Hello-FPGA/BISS-C/doc/BISS_EB-SCH.pdf

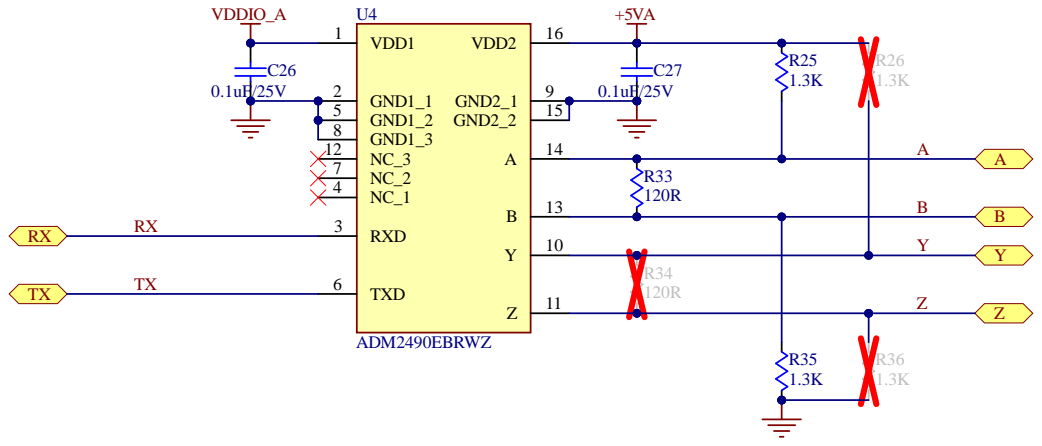
[picture p5: page 1]

R evisio n | Modified desc riptions / ECN List | Date | | roduct Num: Title: P roduct Title : | ' ' * | Che cked By: | X X X

Schematic Revision History | | | BISS_EB | Designed By: | X X X | Cannot open fi le \ Chenhy\pcb设计相关资 料 \Proj e c t模板 \ Logo2020.png. Fi le does not exi s t .

P | ' | Approve By: | X

evision | | She et: | / * | Siz e | A | R ele ase Date | :

Schematic Revision History | | | Title: | BISS_EB | Designed By: | XXX | Cannot open file \Chenhy\pcb设计相关资料\Project模板\Logo2020.png. File does not exist.

Revision | Modified descriptions / ECN List | Date | | | Product Title: | ''* | Checked By: | XXX

Product Num: | '' | Approve By: | XXX

Revision: | V01 | Sheet: | * * | Size: | A3 | Release Date: | 2021/11/23

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

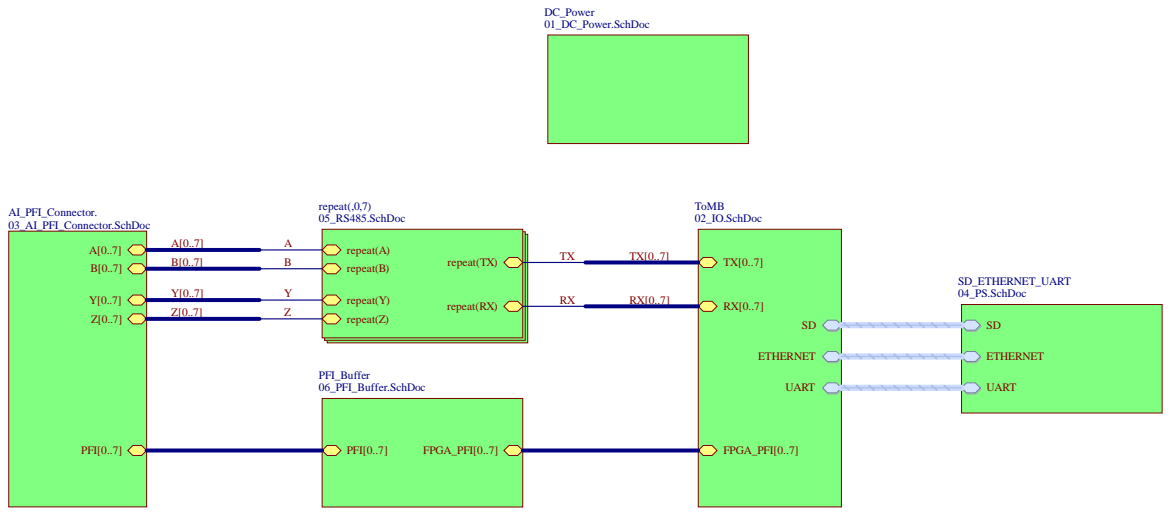
[picture p6: page 9]
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

Revision | Modified descriptions / ECN List | Date | | | Product Title: | ''* | Checked By: | XXX

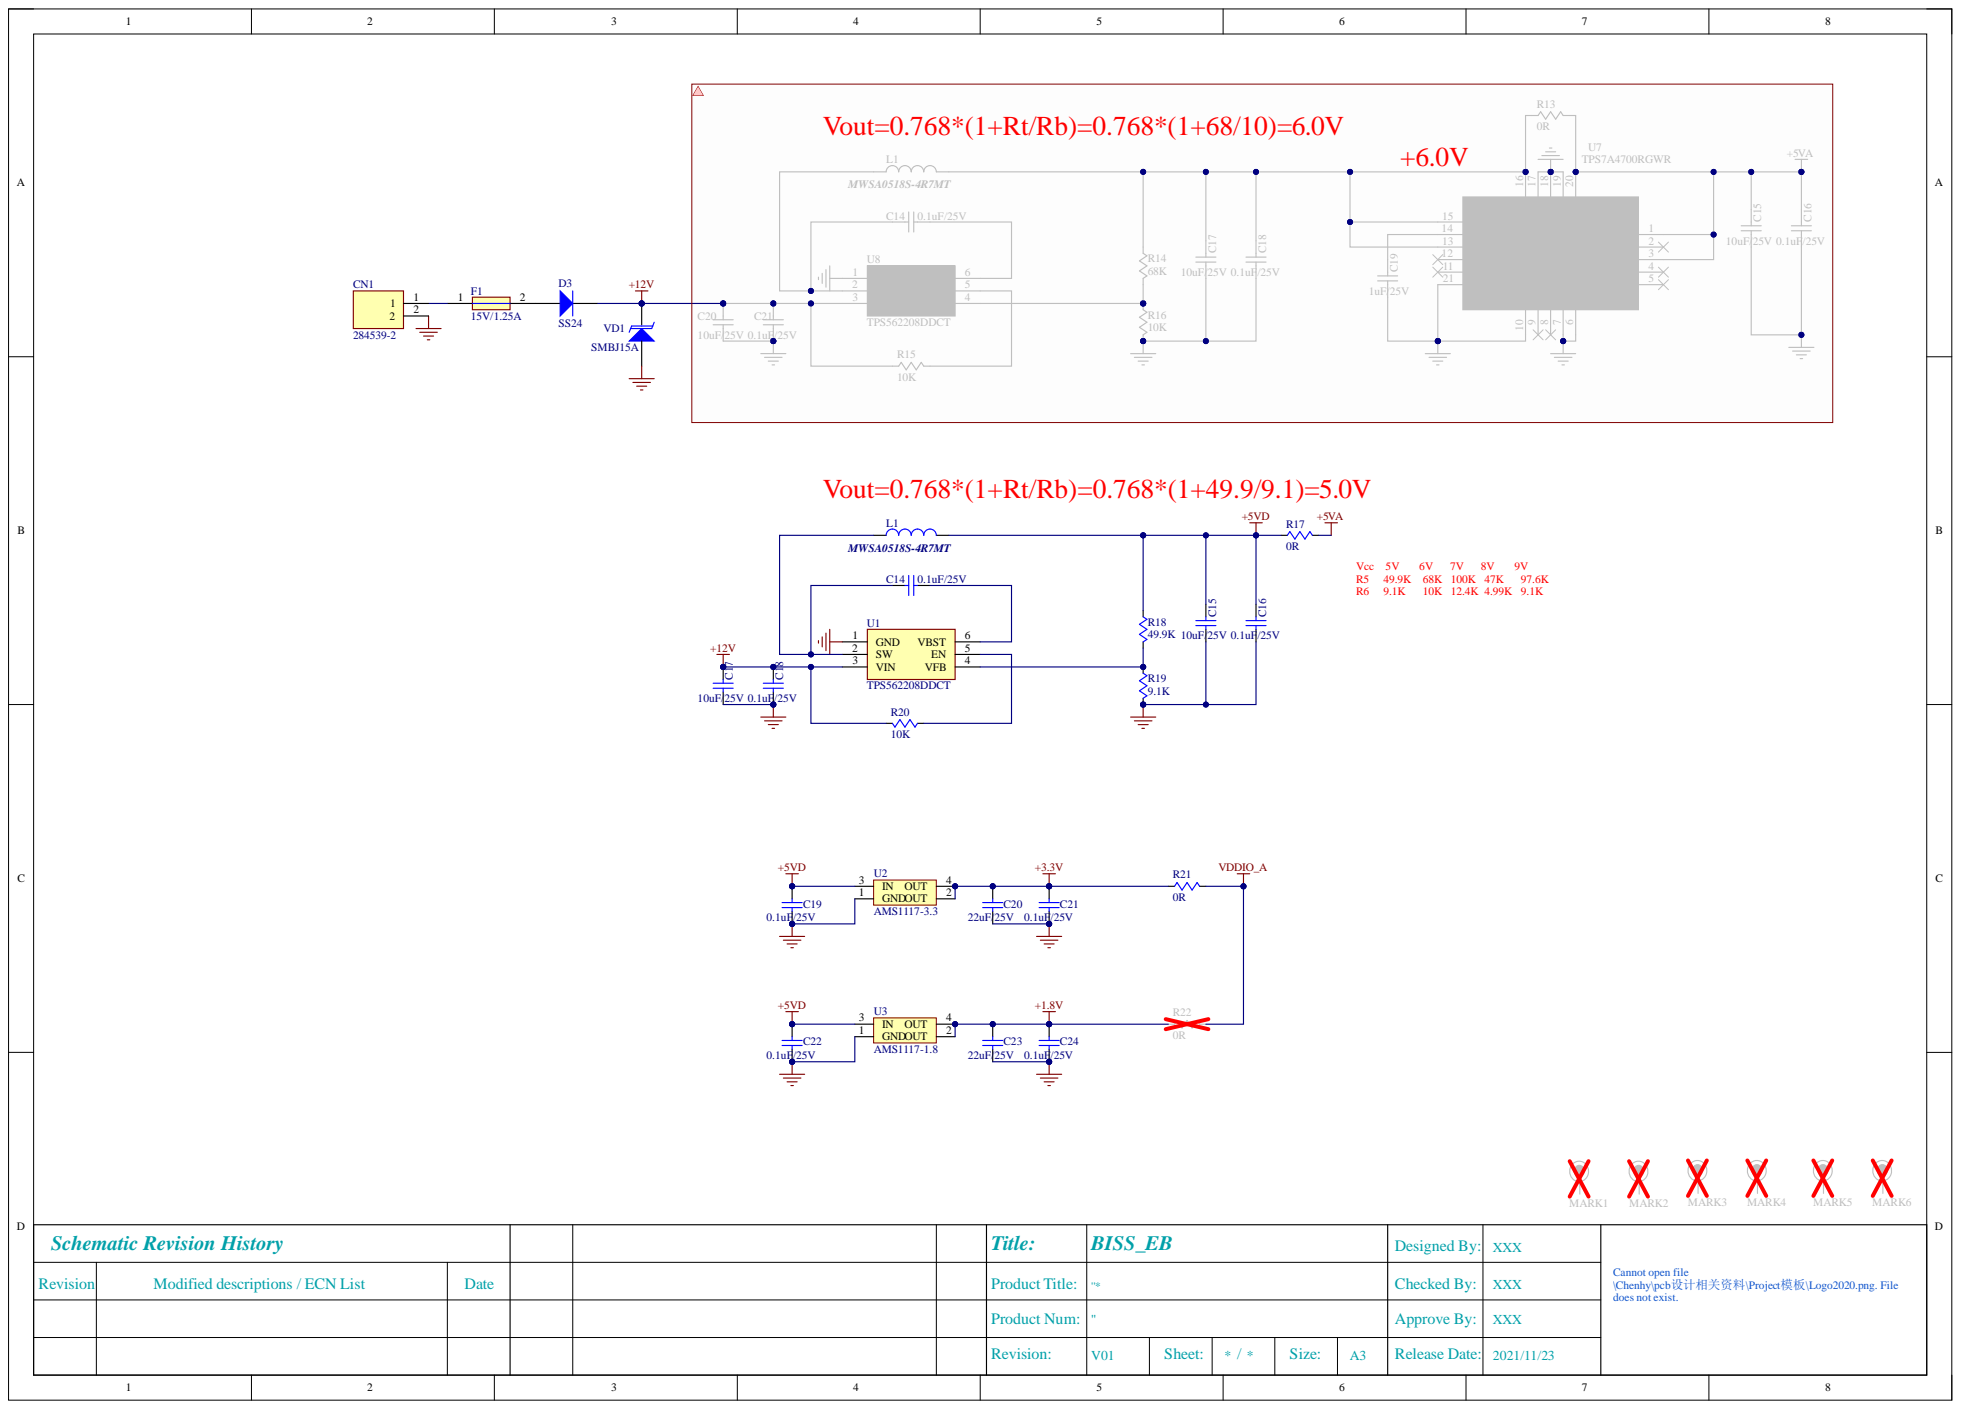
[picture p7: page 10]

U1
GND 1

VIN 3

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

Revision | Modified descriptions / ECN List | Date | | | Product Title: | ''* | Checked By: | XXX

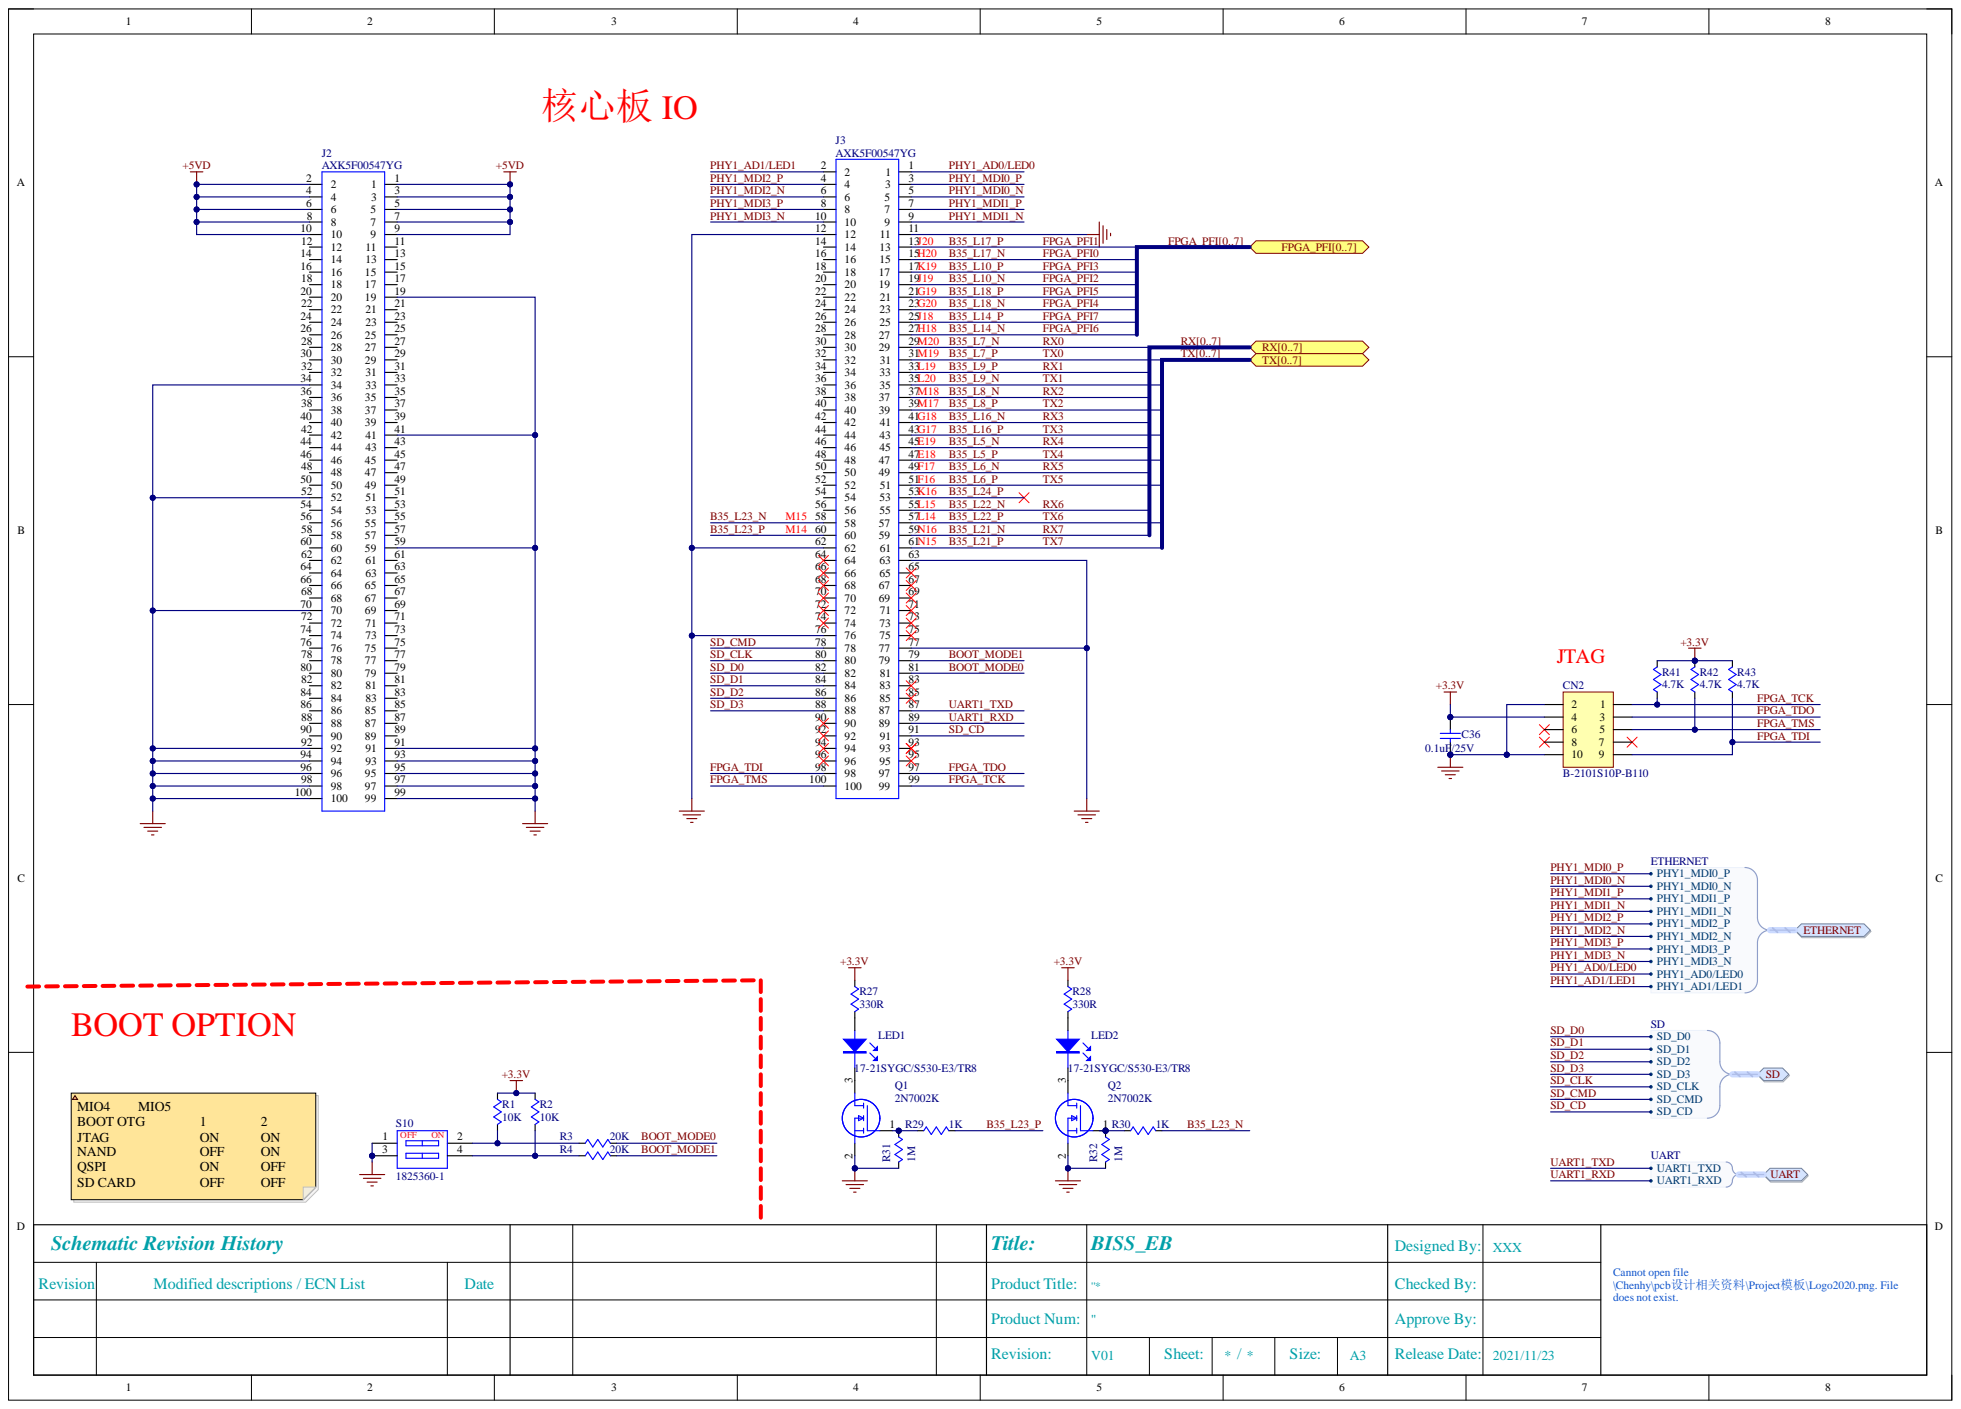
[picture p8: page 11]

B35_L23_N M15 B35_L23_P M14 | J20 B35_L17_P FPGA_PFI1

H20 B35_L17_N FPGA_PFI0

M19 B35_L7_P TX0
L19 B35_L9_P RX1

N16 B35_L21_N RX7
N15 B35_L21_P TX7

SD_CMD SD_CLK SD_D0 SD_D1 SD_D2 SD_D3 FPGA_TDI FPGA_TMS

BOOT_MODE1 BOOT_MODE0 UART1_TXD UART1_RXD SD_CD FPGA_TDO FPGA_TCK

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

Revision | Modified descriptions / ECN List | Date | | | Product Title: | ''* | Checked By:

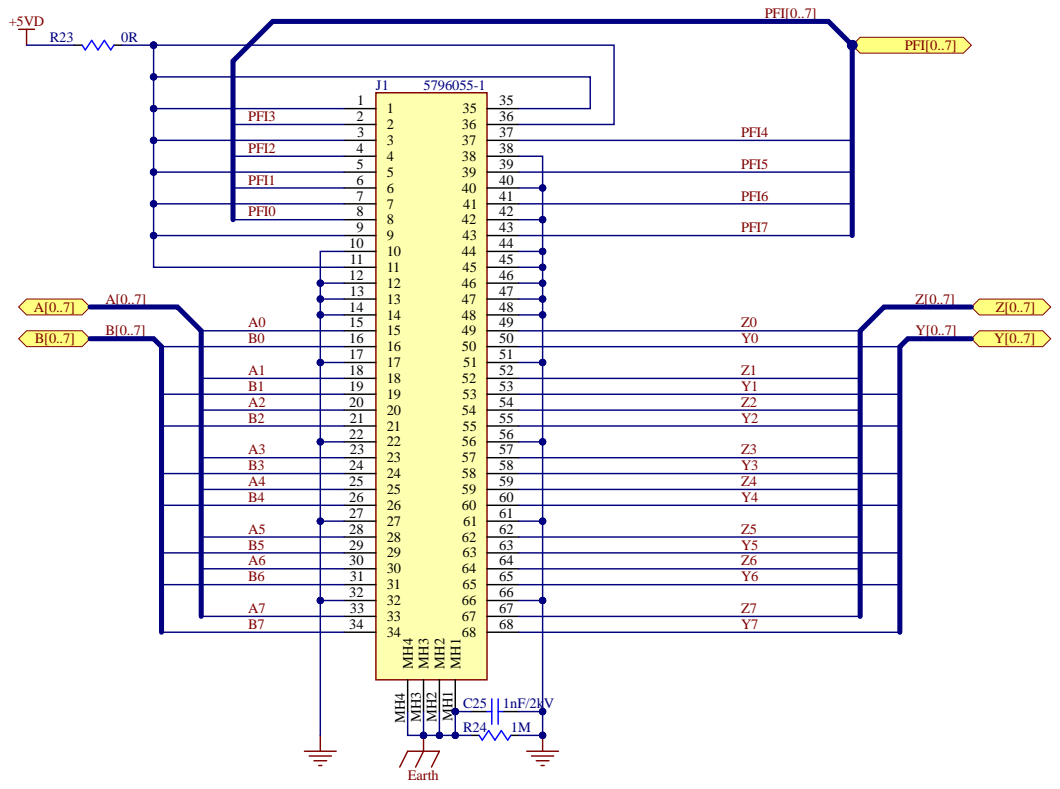
[picture p9: page 12]

PFI3 | 2 2

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

Revision | Modified descriptions / ECN List | Date | | | Product Title: | ''* | Checked By: | XXX

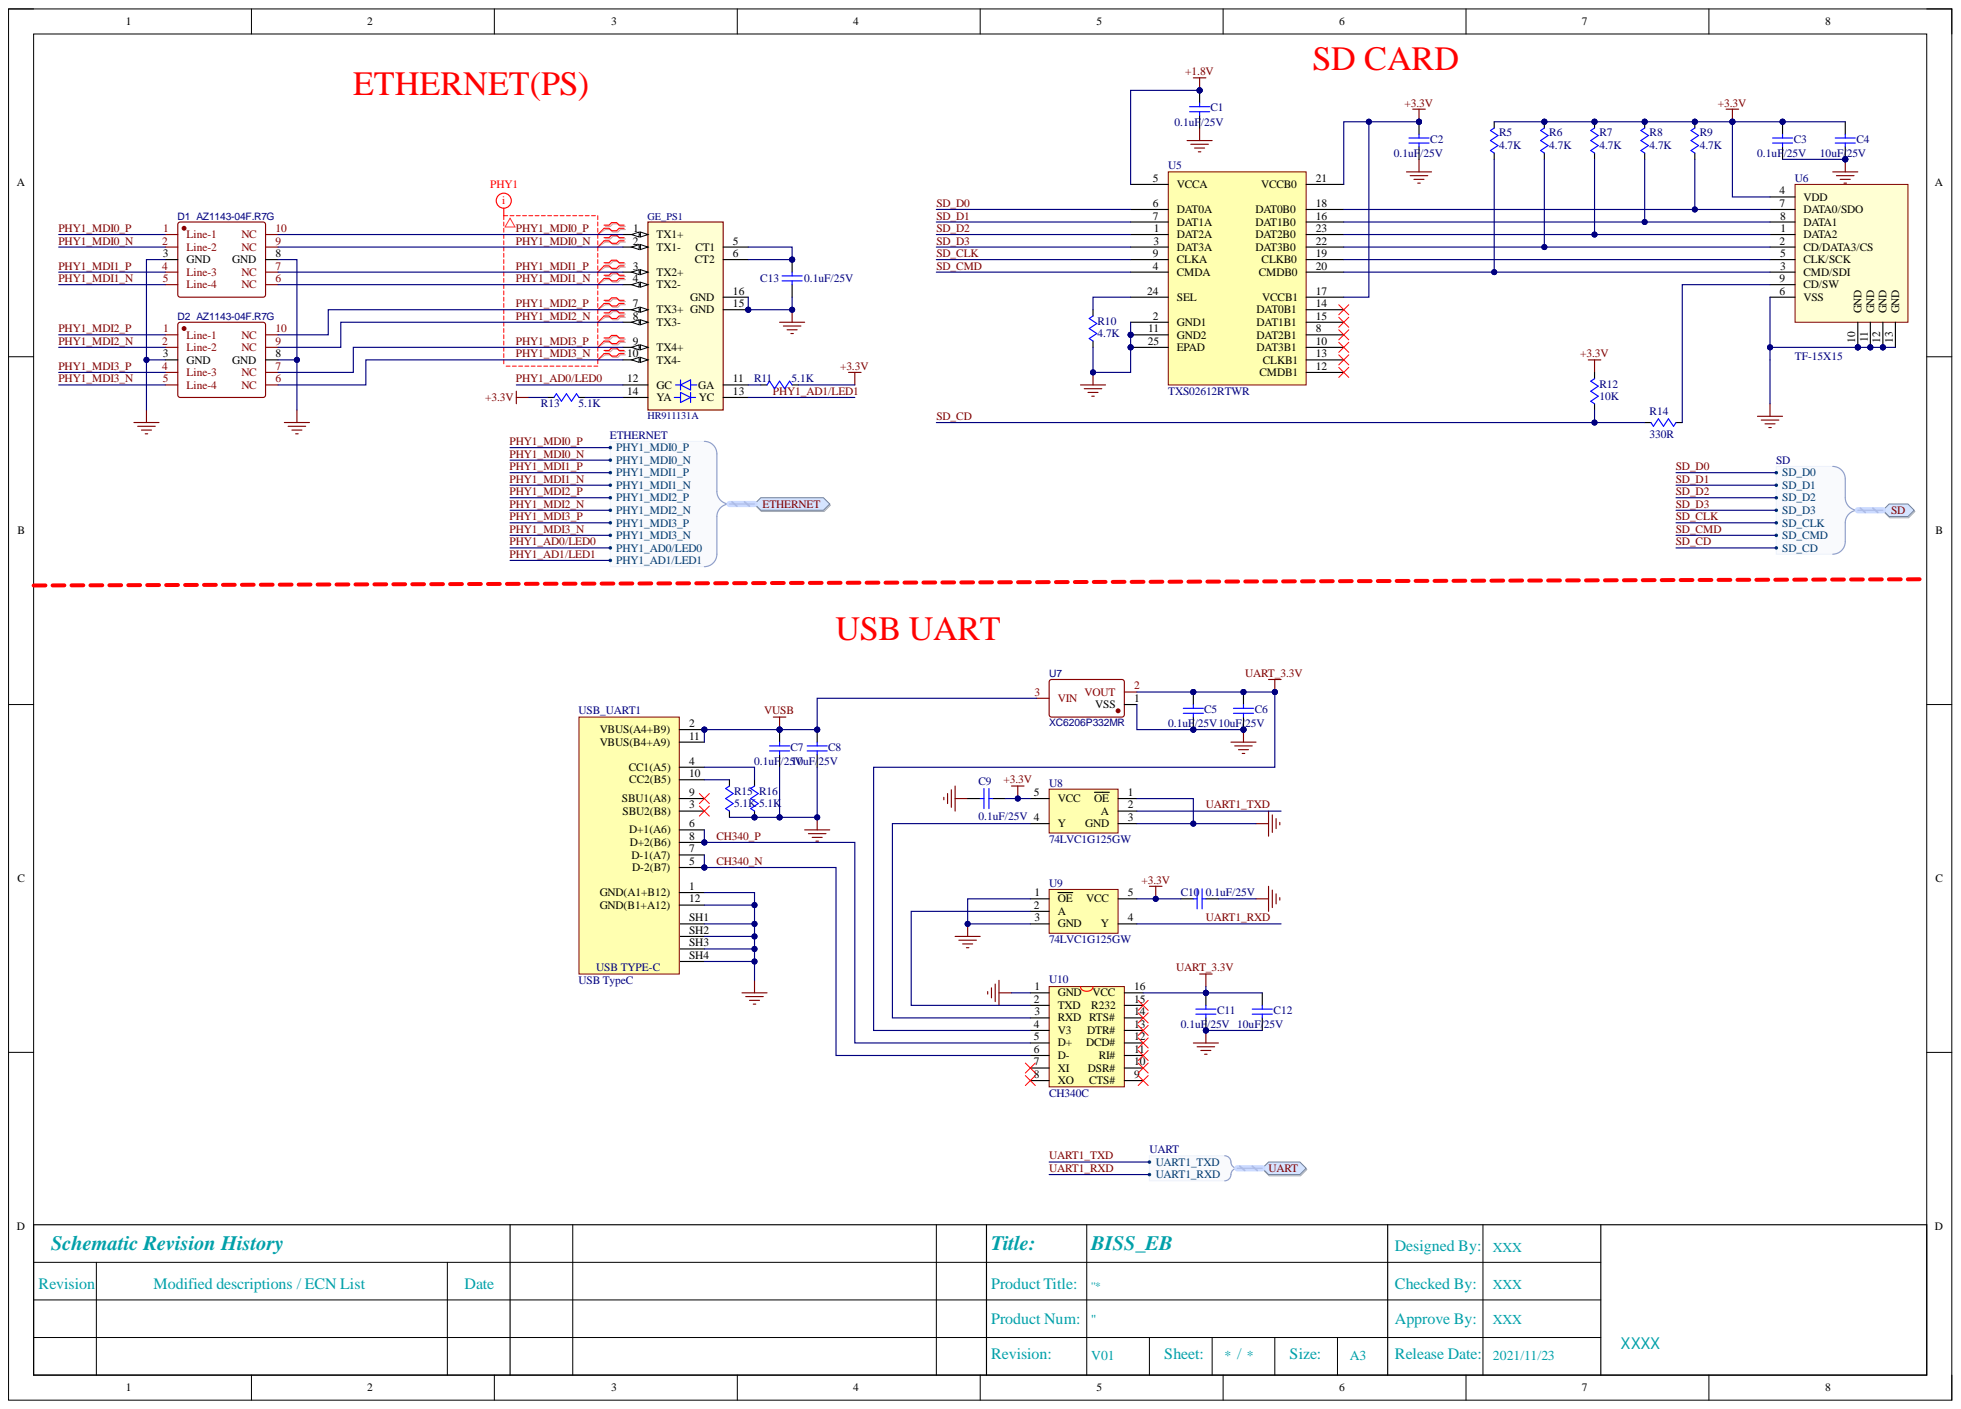
[picture p10: page 13]

SEL 24 | | CD/SW 9

VSS 6

VIN 3

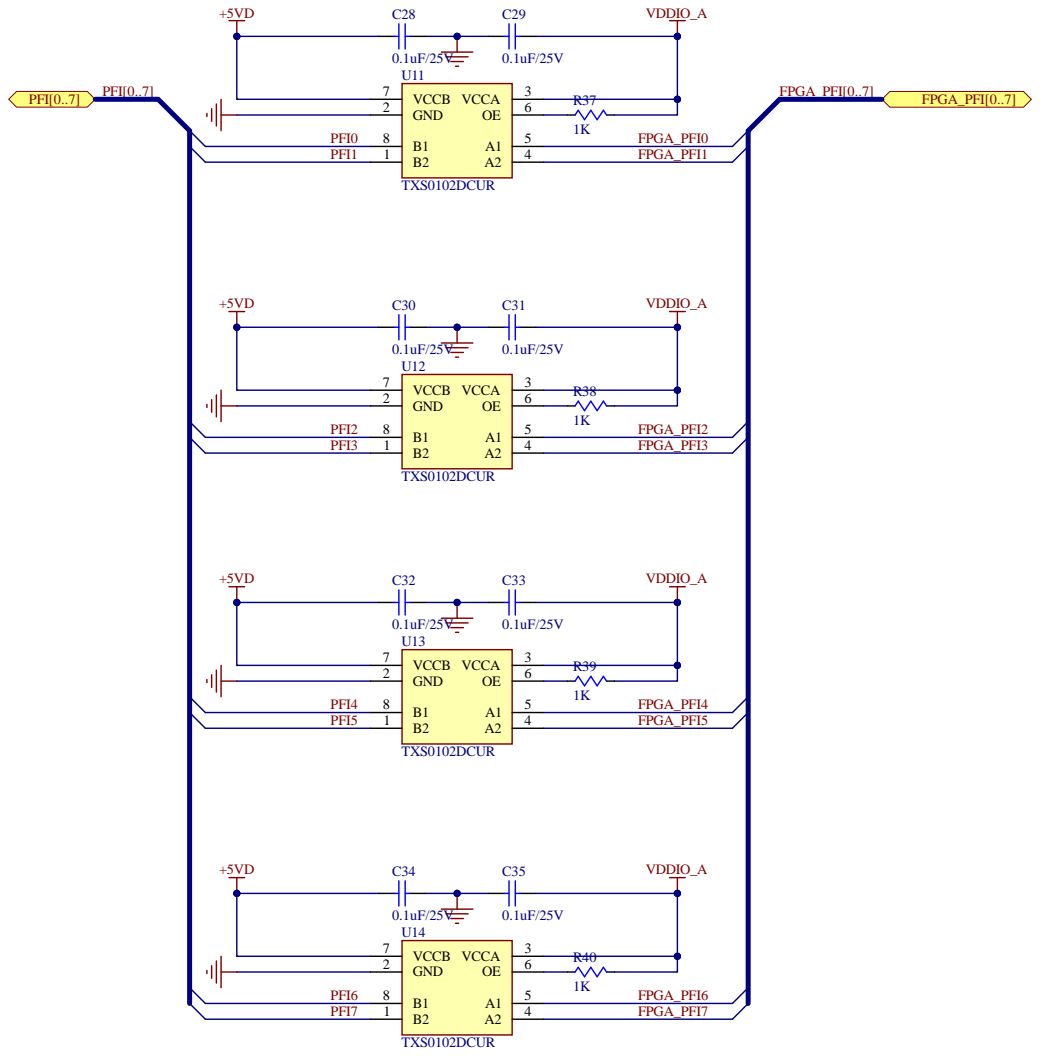
[picture p11: page 14]
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

Revision | Modified descriptions / ECN List | Date | | | Product Title: | ''* | Checked By: | XXX
