Hello-FPGA/BISS-C/doc/ZYNQ 7020&7010 Core.pdf

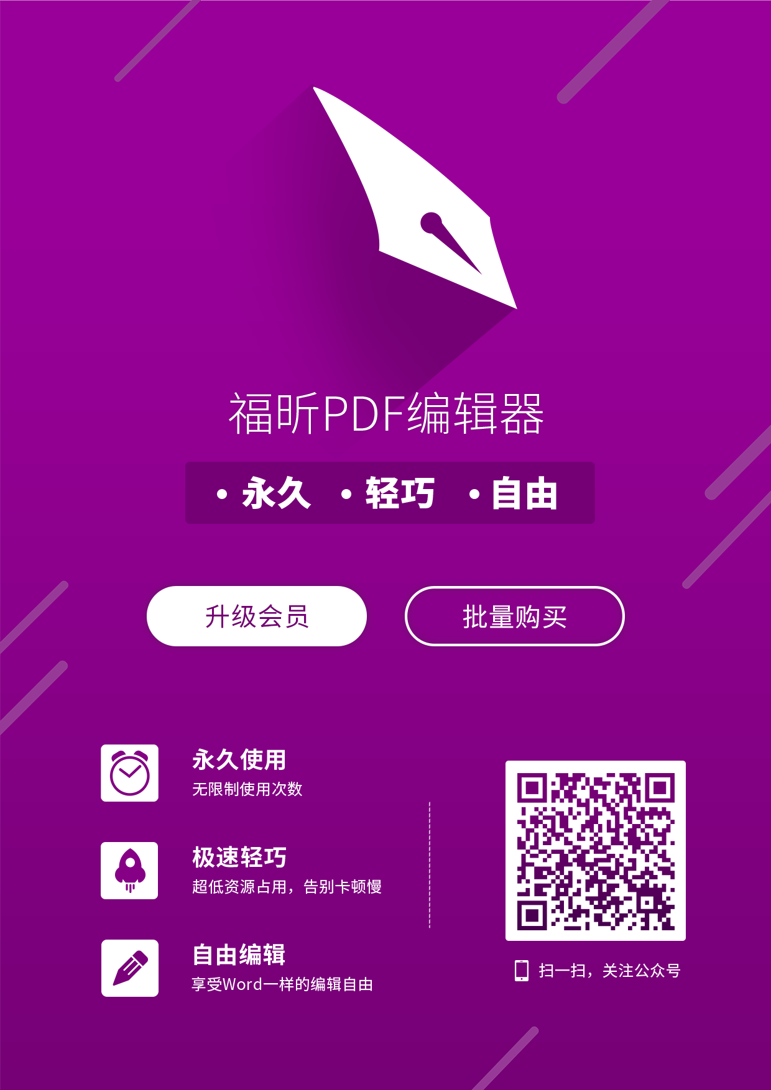
[picture p12: page 1]

## QSPI Flash [Winbond]

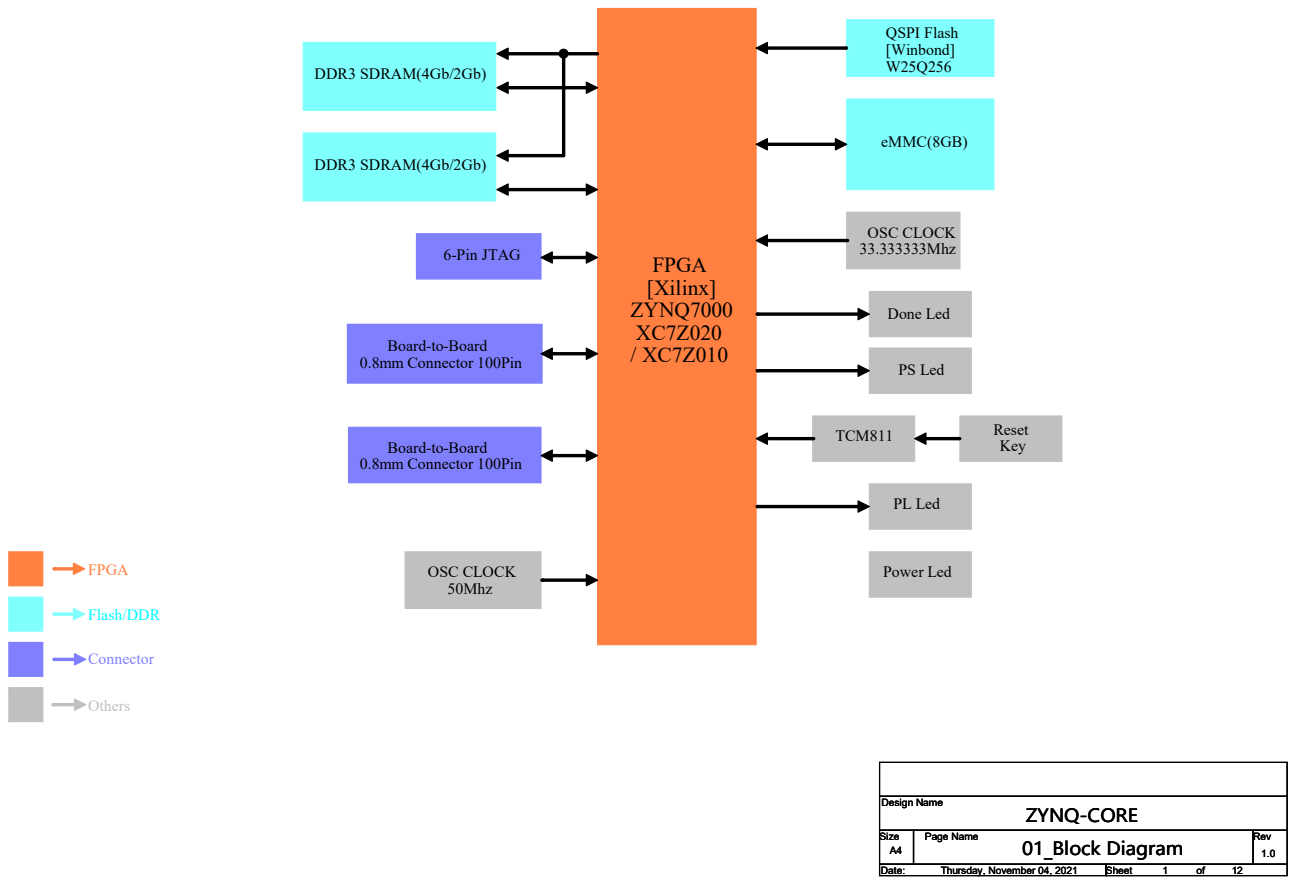
[picture p13: page 2]
eMMC(8GB); DDR3 SDRAM(4Gb/2Gb); 6-Pin JTAG; FPGA; OSC CLOCK; 50Mhz; Flash/DDR; OSC CLOCK 33.333333Mhz; Done Led; PS Led; TCM811; Reset; Key; PL Led; Power Led; FPGA [Xilinx] ZYNQ7000 XC7Z020 / XC7Z010; Connector; Others; Design Name; ZYNQ-CORE

Board-to-Board
0.8mm Connector 100Pin

Size A4 | Page Name 01_Block Diagram 01_Block Diagram 01_Block Diagram | Rev 1.0

Date: Thursday, November 04, 2021 Thursday, November 04, 2021 Thursday, November 04, 2021 | Sheet 1 1 1 of 12 12 12

# BANK0

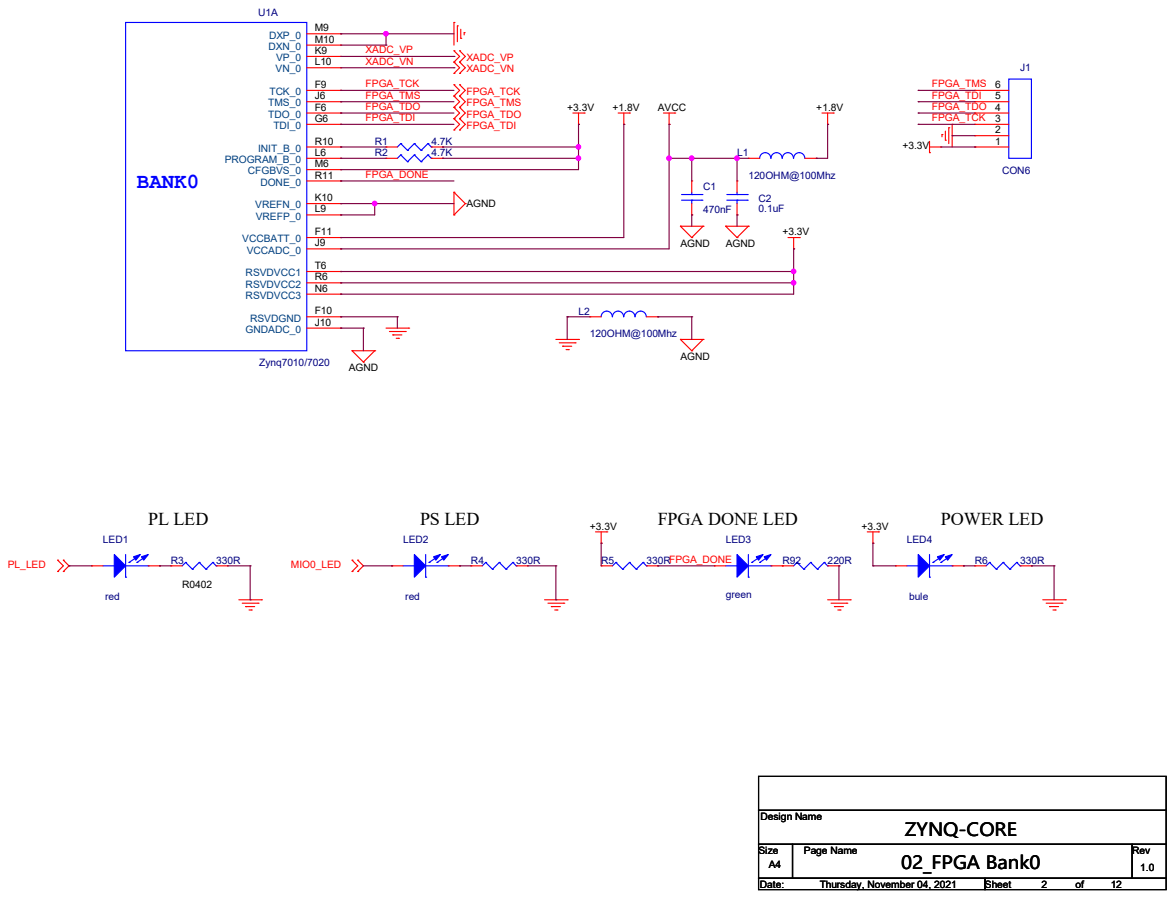
[picture p14: page 3]

## BANK34

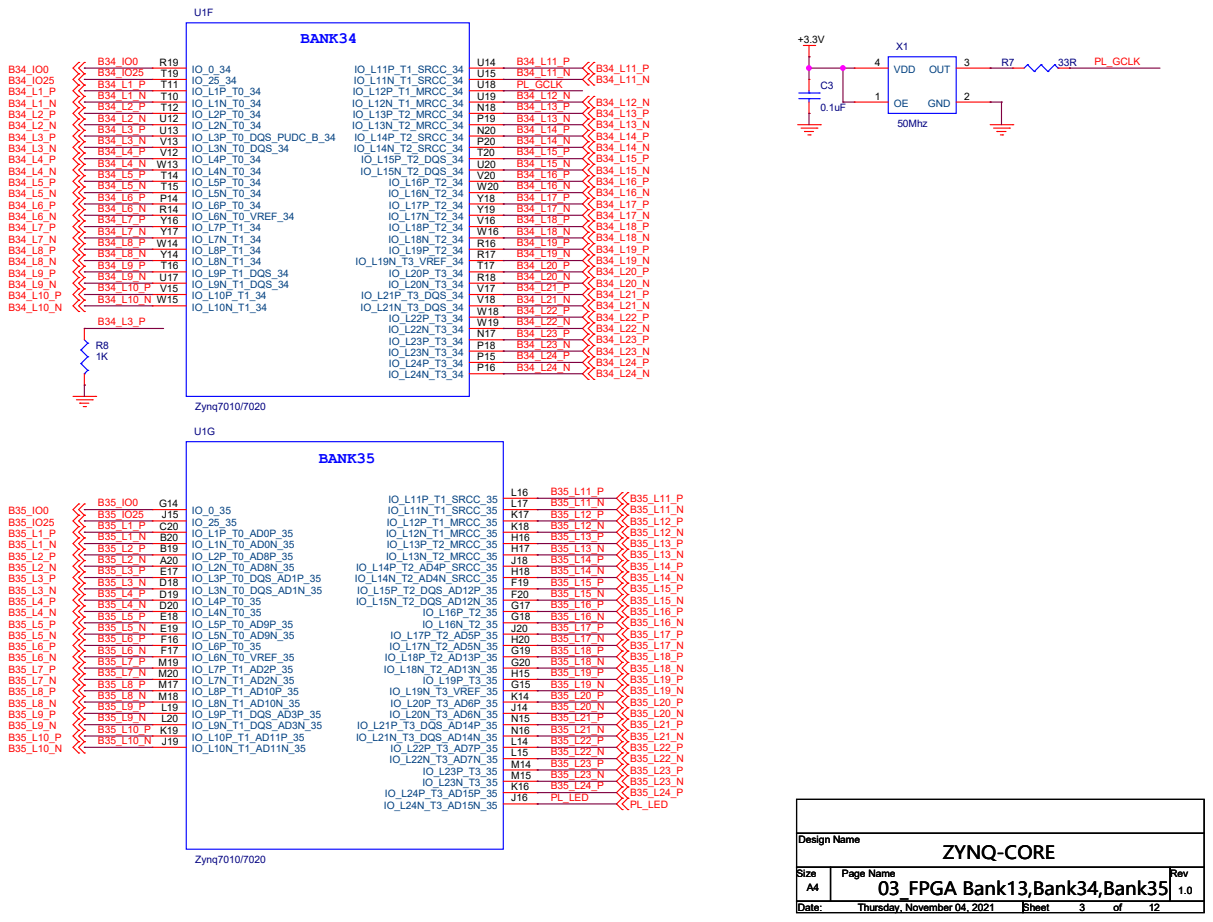
[picture p15: page 4]

# VOLTAGE/JTAG/PLL OPTION

# BANK500

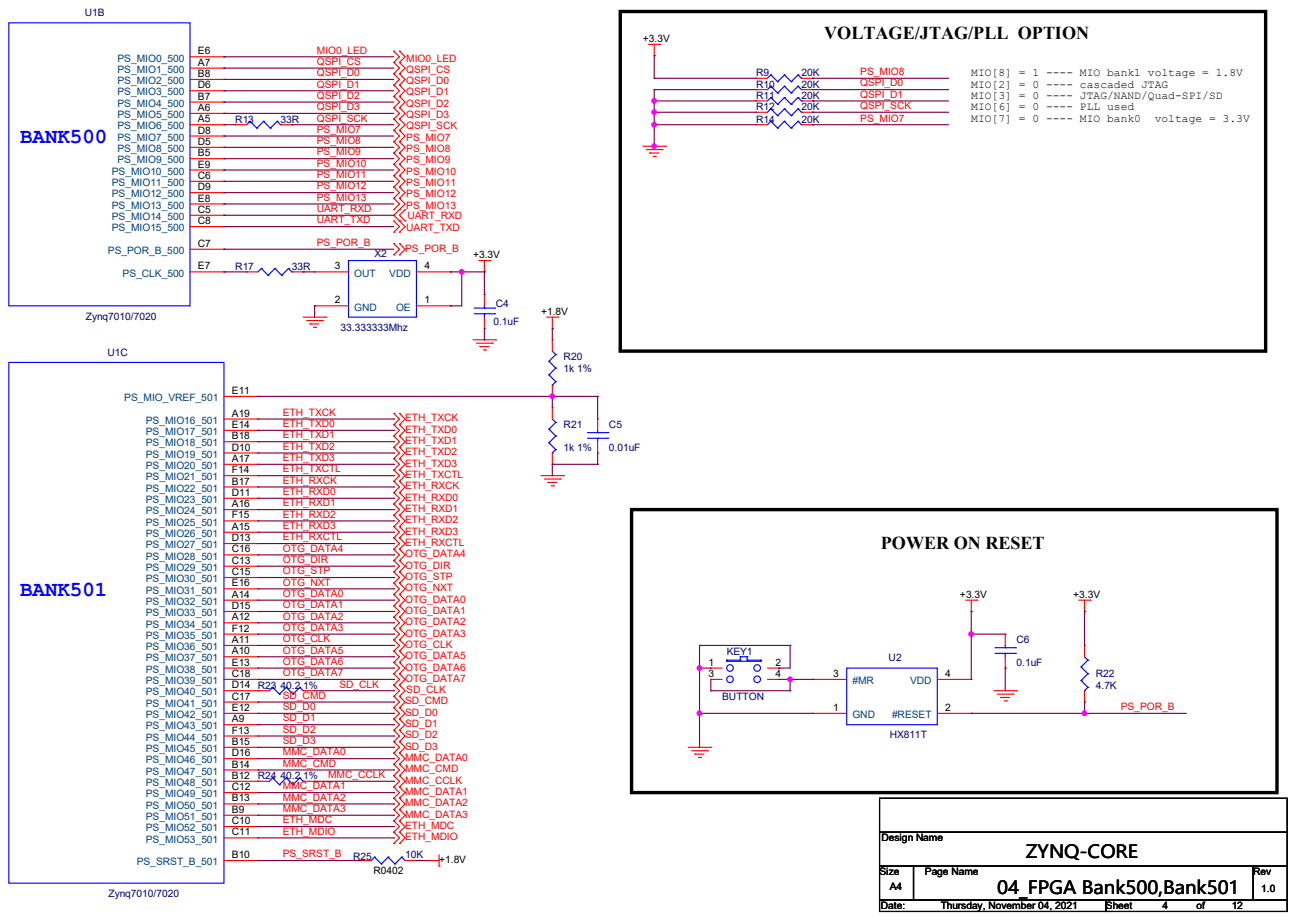
[picture p16: page 5]

MIO[8] = 1 ---- MIO bank1 voltage = 1.8V
MIO[2] = 0 ---- cascaded JTAG
MIO[3] = 0 ---- JTAG/NAND/Quad-SPI/SD
MIO[6] = 0 ---- PLL used
MIO[7] = 0 ---- MIO bank0 voltage = 3.3V

# BANK502

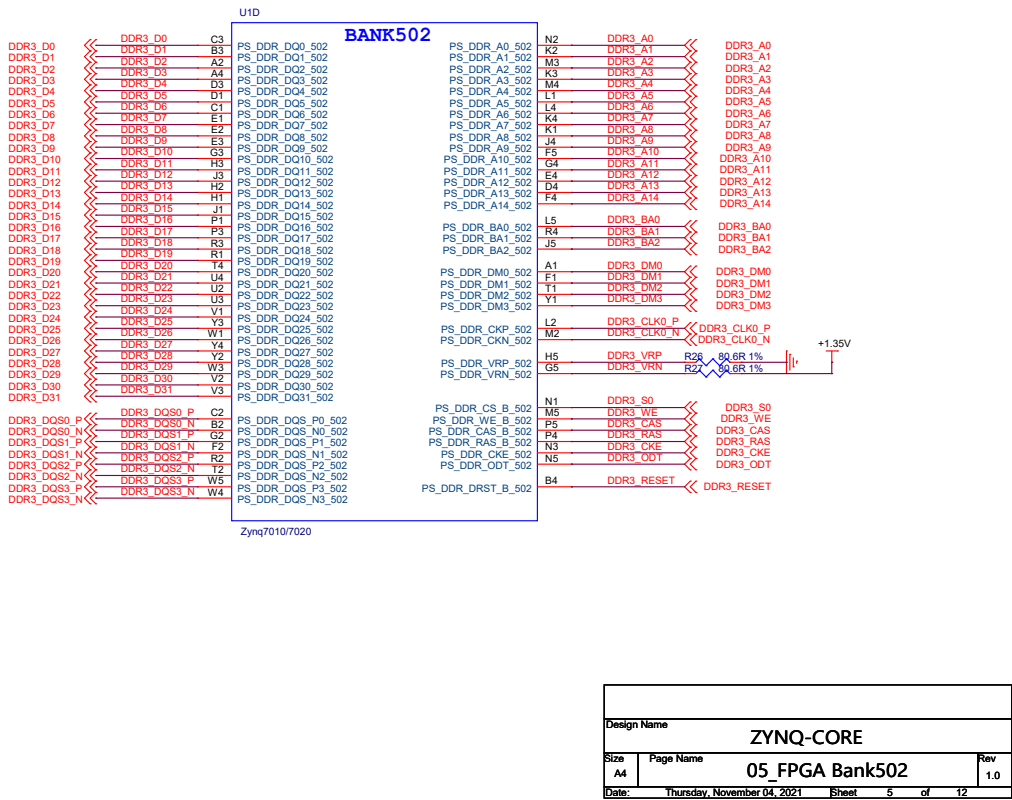
[picture p17: page 6]

05_FPGA Bank502 05_FPGA Bank502 05_FPGA Bank502

Thursday, November 04, 2021 Thursday, November 04, 2021 Thursday, November 04, 2021 | 5 5 5 12 12 12

5

4

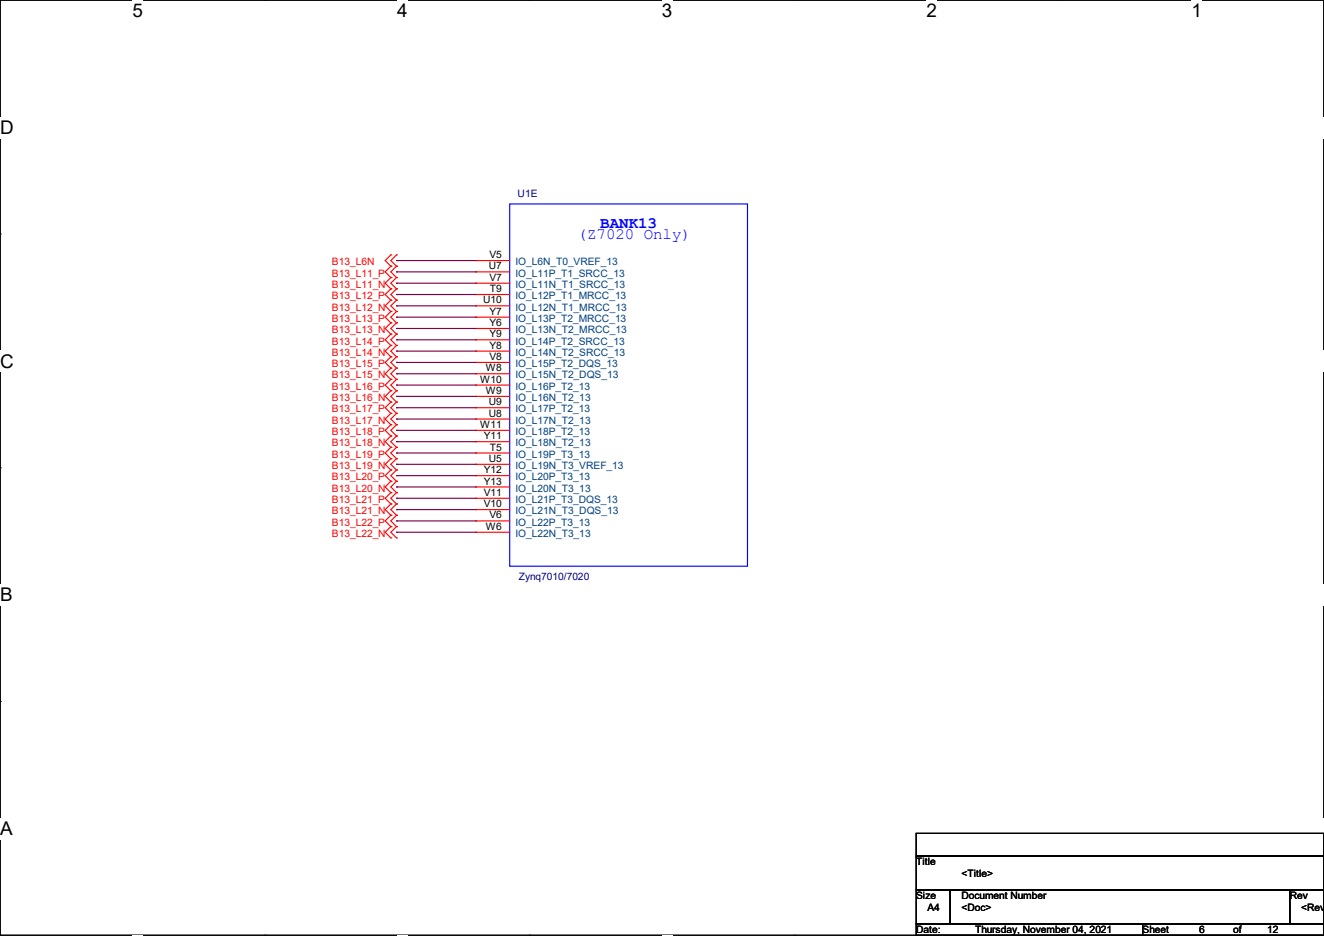
[picture p18: page 7]
Title; Size; Document Number; Rev; <Doc>; <RevCode>; <Title>; Thursday, November 04, 2021; BANK13 (Z7020 Only); Zynq7010/7020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

### VCCO_13

VCCINT | VCC_PAUX

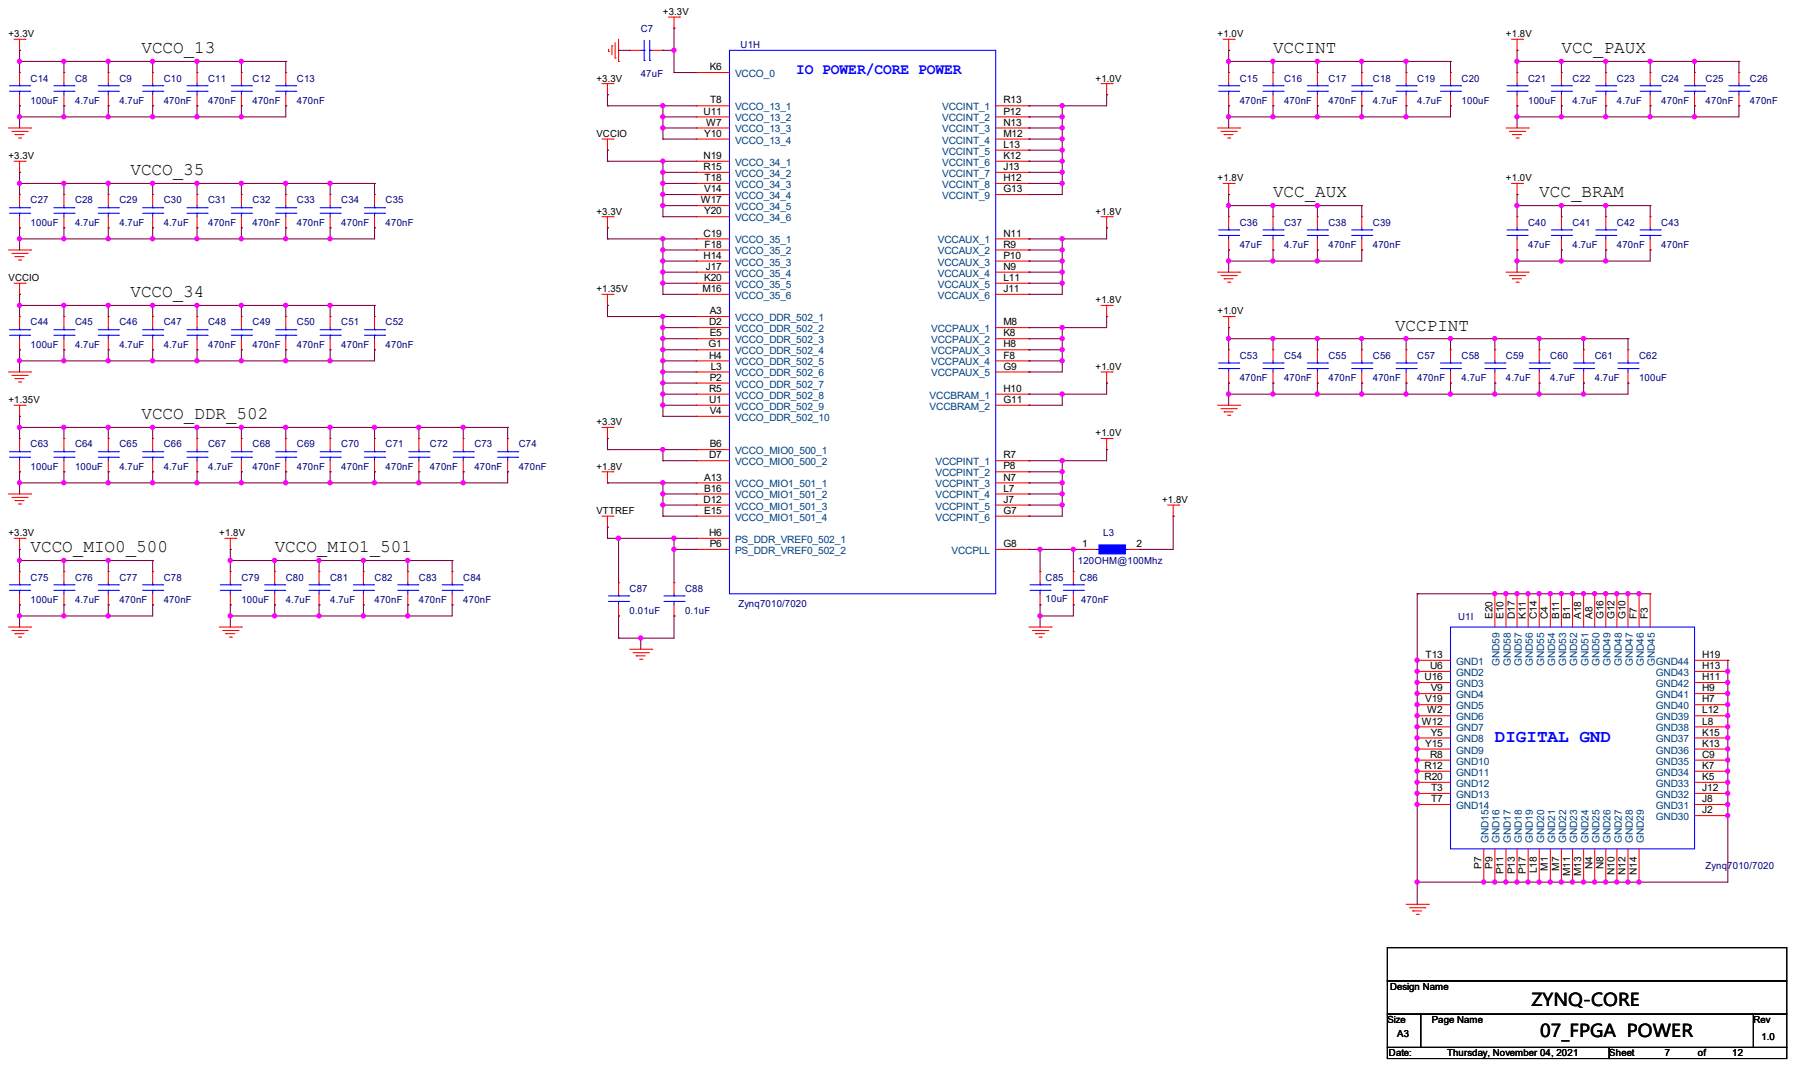
[picture p19: page 8]

IO POWER/CORE POWER U1H

DDR3_DQS0_P DDR3_D6 DDR3_D5 DDR3_D2 DDR3_D0 DDR3_D3 DDR3_D4 DDR3_D1 DDR3_D7 DDR3_D14 DDR3_D8 DDR3_D12 DDR3_D9 DDR3_D13 DDR3_D11 DDR3_D15 DDR3_D10 DDR3_DM0 DDR3_DM1

DDR3_A0 DDR3_A1 DDR3_A2 DDR3_A3 DDR3_A4 DDR3_A5 DDR3_A6 DDR3_A7 DDR3_A8 DDR3_A9 DDR3_A10 DDR3_A11 DDR3_A12 DDR3_A13 DDR3_A14 DDR3_BA0 DDR3_BA1 DDR3_BA2 DDR3_CLK0_P DDR3_CLK0_N

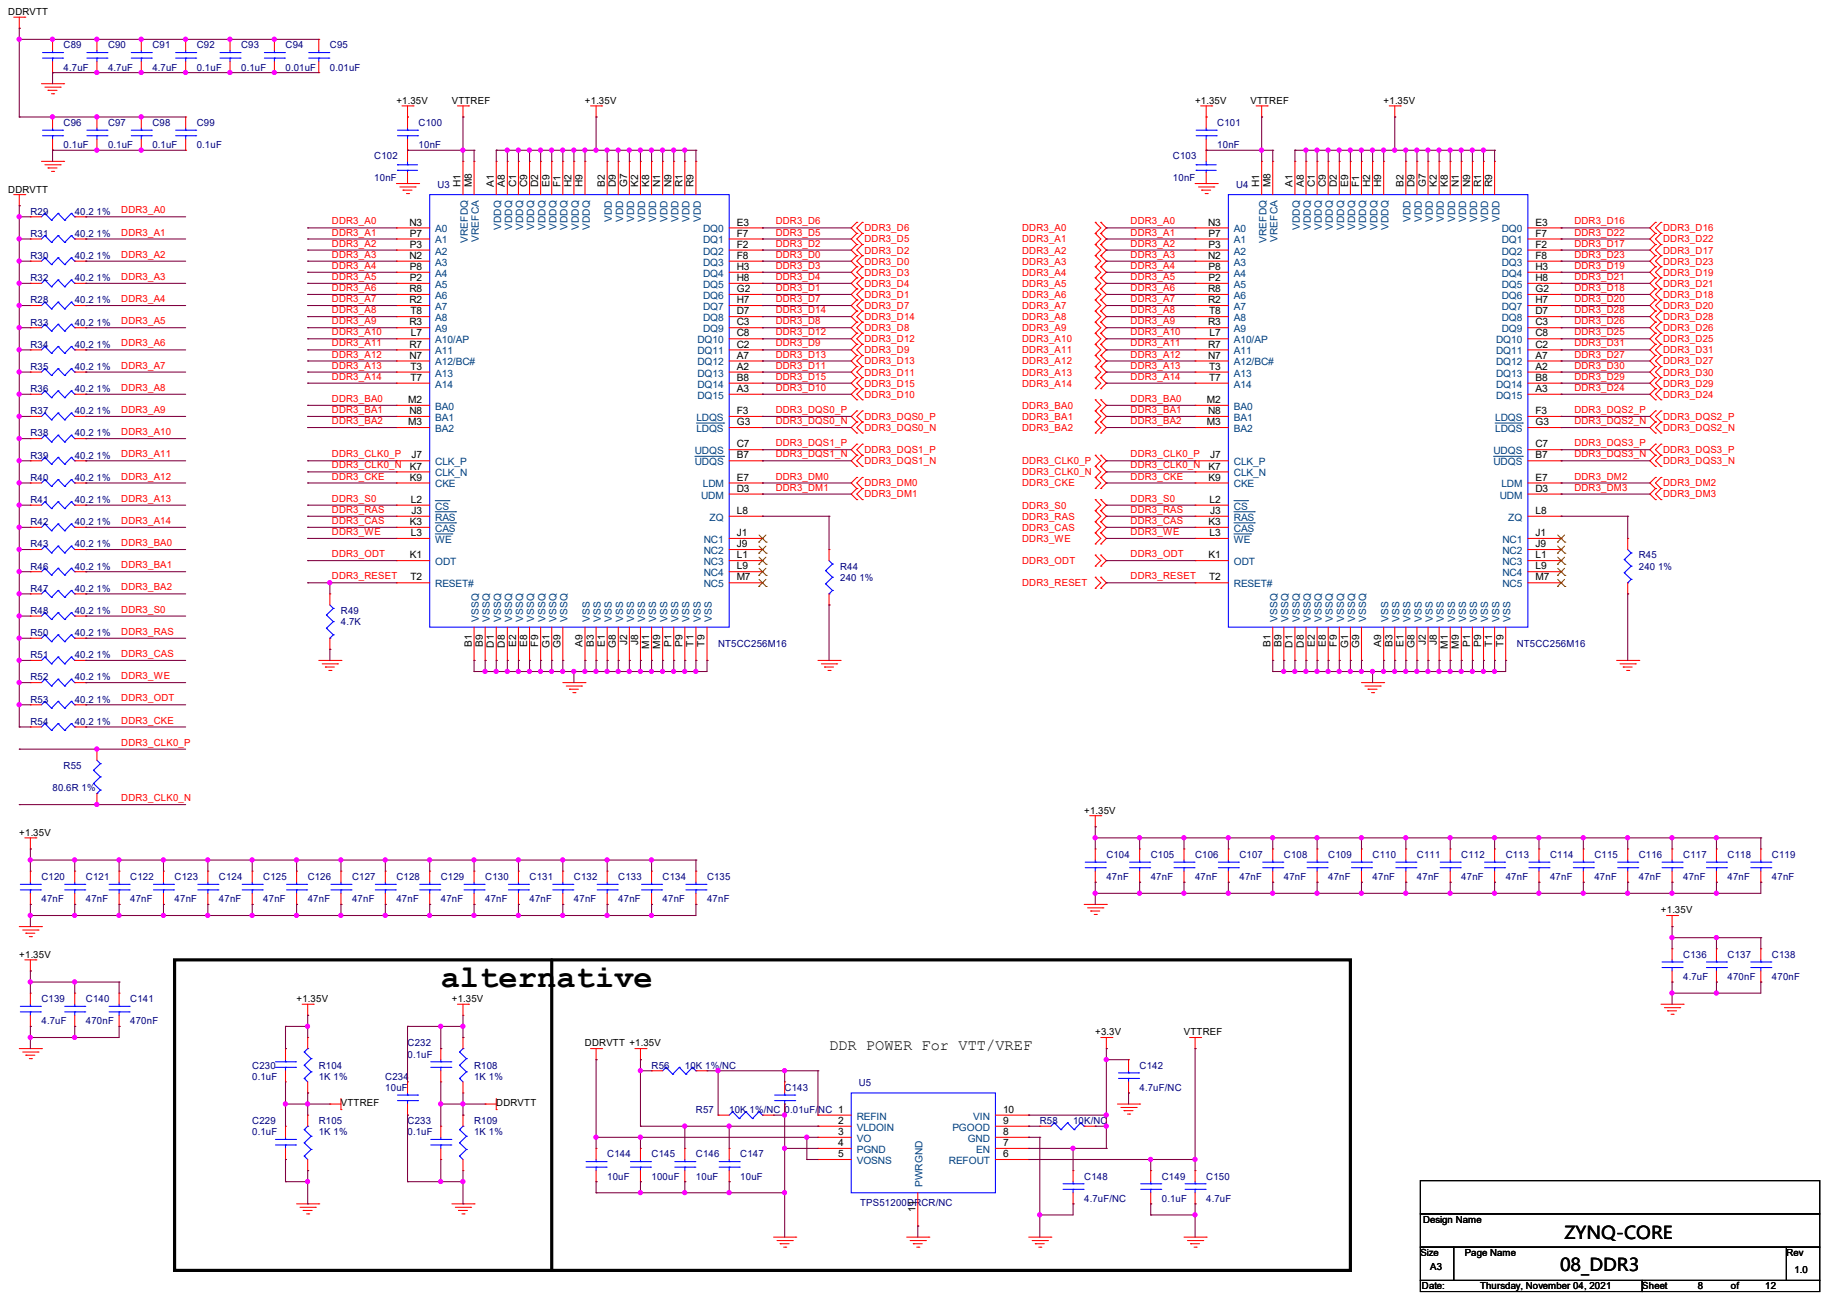
[picture p20: page 9]

DDR POWER For VTT/VREF

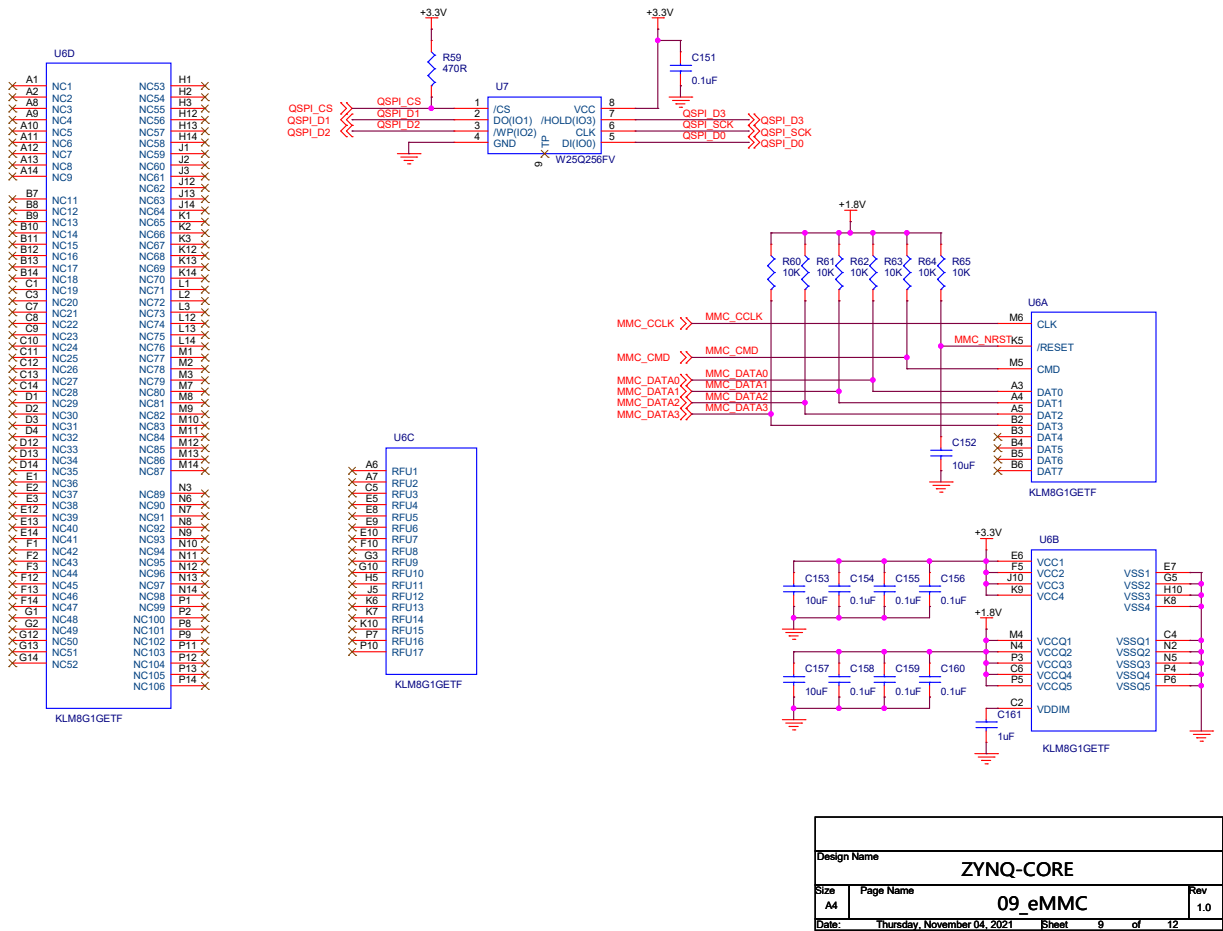
[picture p21: page 10]

## 1.0V POWER@2A

## Vout=0.6*R1/R2+0.6

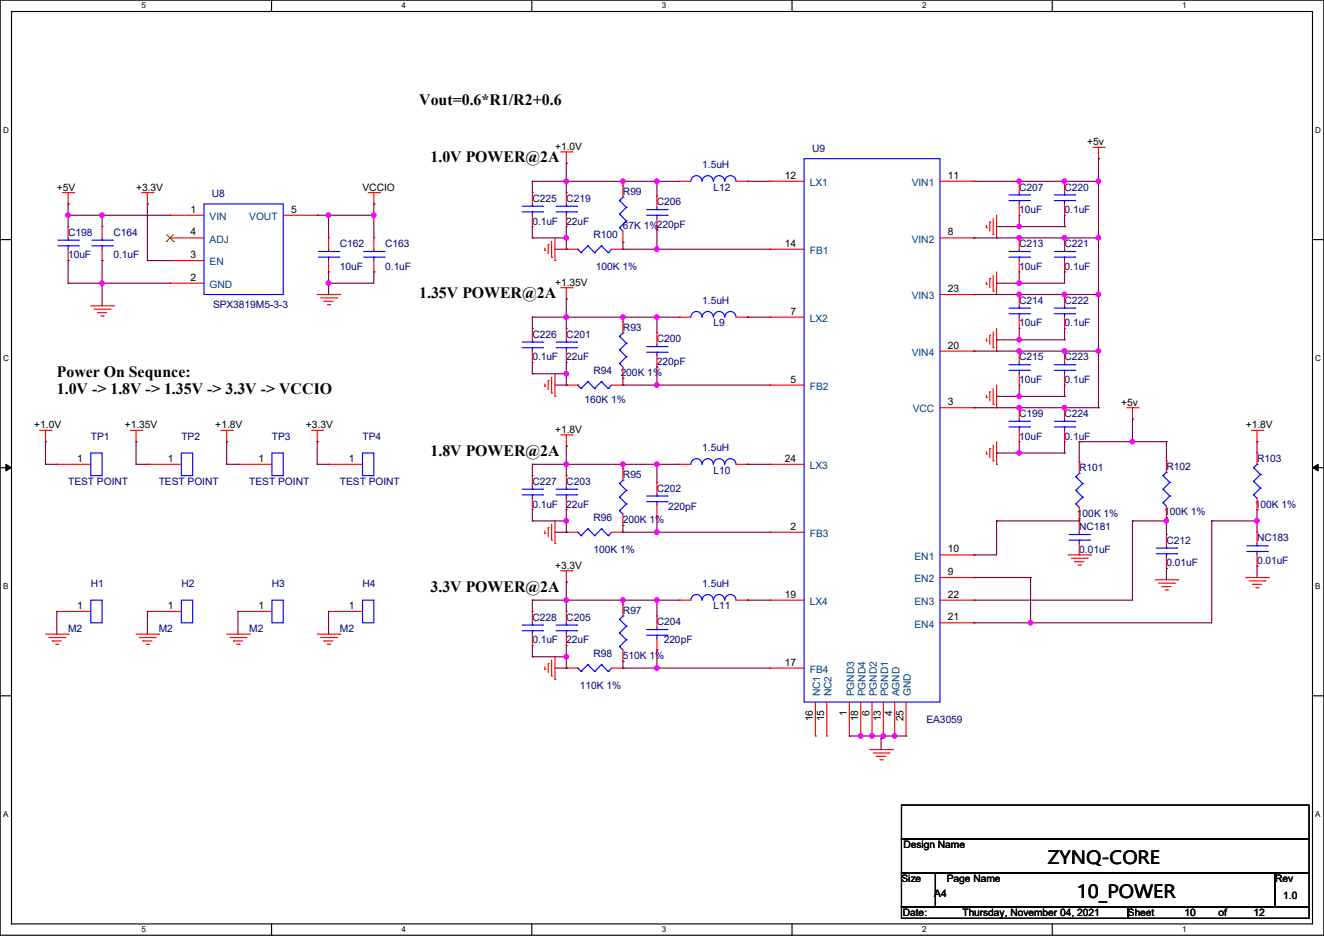
[picture p22: page 11]

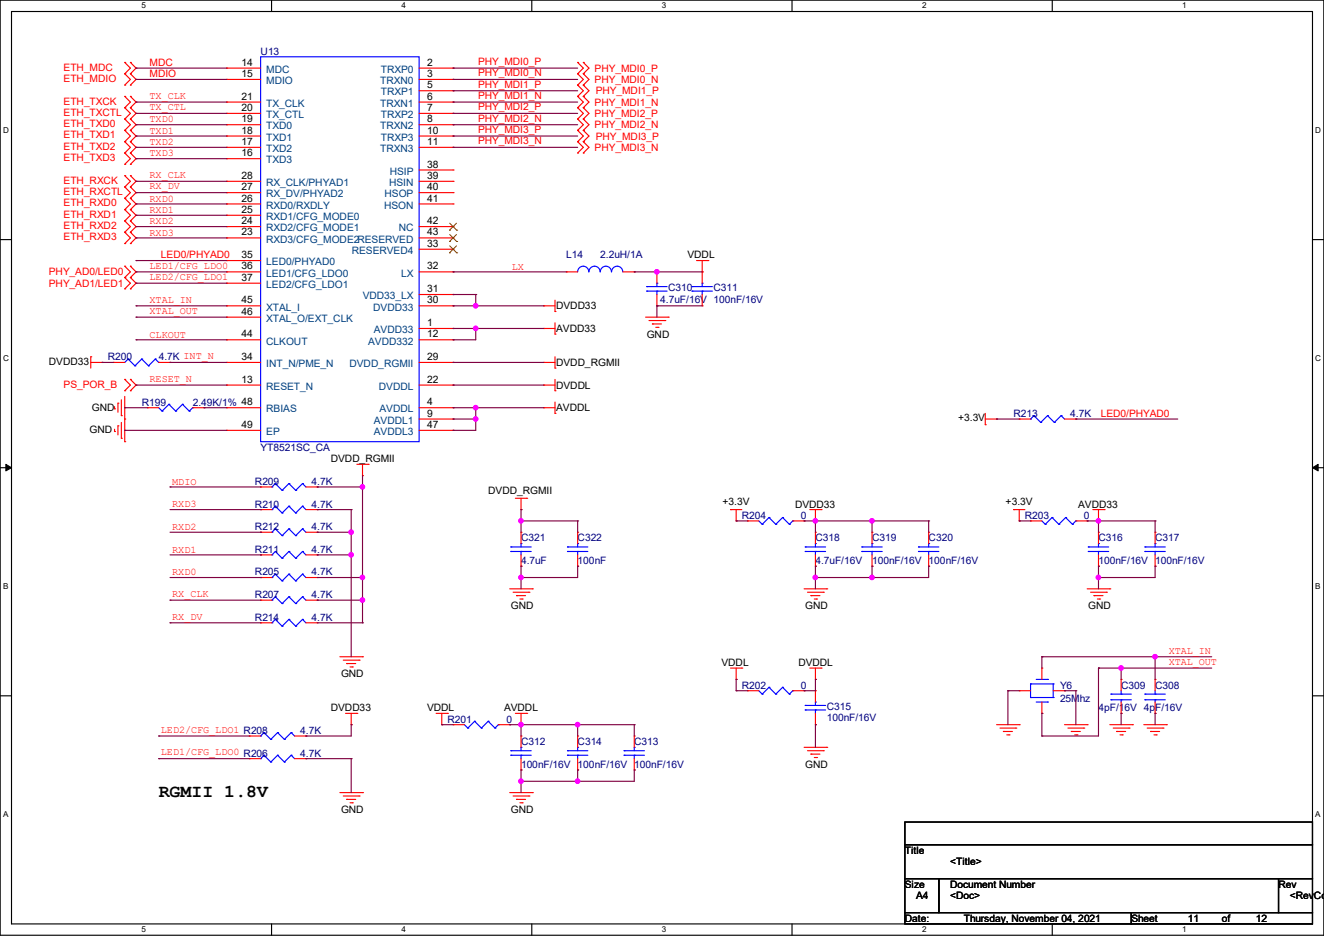
[picture p23: page 12]

Header_2X50_0.8mm 1 1 | 3 3 | 4 | 4 5 5 | 6 | 6 7 7 | 8 | 8 9 9
10 | 10 11 11 | 12 | 12 13 13 | 14 | 14 15 15 | 16 | 16 17 17 | 18 | 18 19 19 | 20 | 20 21 21 | 22 | 22 23 23 | 24 | 24 25 25 | 26 | 26 27 27 | 28 | 28 29 29 | 30 | 30 31 31 | 32 | 32 33 33 | 34 | 34 35 35 | 36 | 36 37 37 | 38 | 38 39 39 | 40 | 40 41 41 | 42 | 42 43 43 | 44 | 44 45 45 | 46 | 46 47 47 | 48 | 48 49 49 | 50 | 50 51 51 | 52 | 52 53 53 | 54 | 54 55 55 | 56 | 56 57 57 | 58 | 58 59 59 | 60 | 60 61 61 | 62 | 62 63 63 | 64 | 64 65 65 | 66 | 66 67 67 | 68 | 68 69 69 | 70 | 70 71 71 | 72 | 72 73 73 | 74 | 74 75 75 | 76 | 76 77 77 | 78 | 78 79 79 | 80 | 80 81 81 | 82 | 82 83 83 | 84 | 84 85 85 | 86 | 86 87 87 | 88 | 88 89 89 | 90 | 90 91 91 | 92 | 92 93 93 | 94 | 94 95 95 | 96 | 96 97 97 | 98 | 98 99 99 | 100 | 100 2 | 2

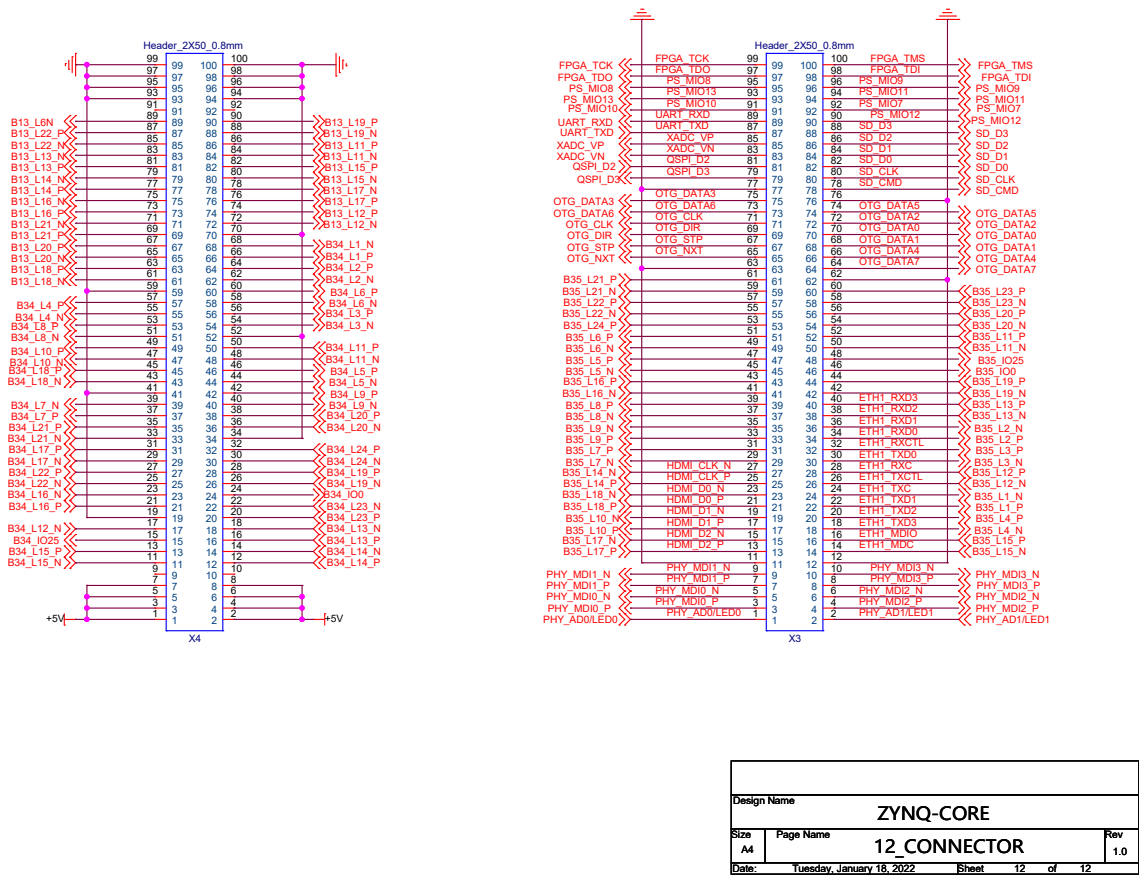
[picture p24: page 13]
UART_RXD UART_TXD; QSPI_D2 QSPI_D3; OTG_NXT; OTG_DATA1; PHY_MDI2_N; PHY_AD1/LED1; PHY_MDI1_P; PHY_AD0/LED0; PHY_MDI1_N; PHY_MDI2_P; OTG_DATA0; OTG_STP; OTG_CLK; OTG_DATA3 OTG_DATA6; OTG_DIR; OTG_DATA7; OTG_DATA4; OTG_DATA2; OTG_DATA5; PS_MIO12; XADC_VP XADC_VN; SD_CMD; SD_CLK; PHY_MDI0_P; PHY_MDI0_N; PHY_MDI3_N PHY_MDI3_P; FPGA_TDO; FPGA_TCK; FPGA_TMS; FPGA_TDI; PS_MIO9; PS_MIO7 PS_MIO13; PS_MIO11; PS_MIO8; PS_MIO10; Design Name; ZYNQ-CORE; Tuesday, January 18, 2022; 12_CONNECTOR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
