Hello-FPGA/BISS-C/(commit log)

2023-10-30 add the demo encoder
2023-11-03 update the demo ,this demo is tested; add axi dma s2mm filter
